daisyaudio/Seed3-DevKit-Eurorack/pcb/Seed3-DevKit-Eurorack-Rev3/Seed3-DevKit-Eurorack-Rev3.kicad_pcb

## KiCad design pcb/Seed3-DevKit-Eurorack-Rev3/Seed3-DevKit-Eurorack-Rev3.kicad_pcb (2026-06-25)

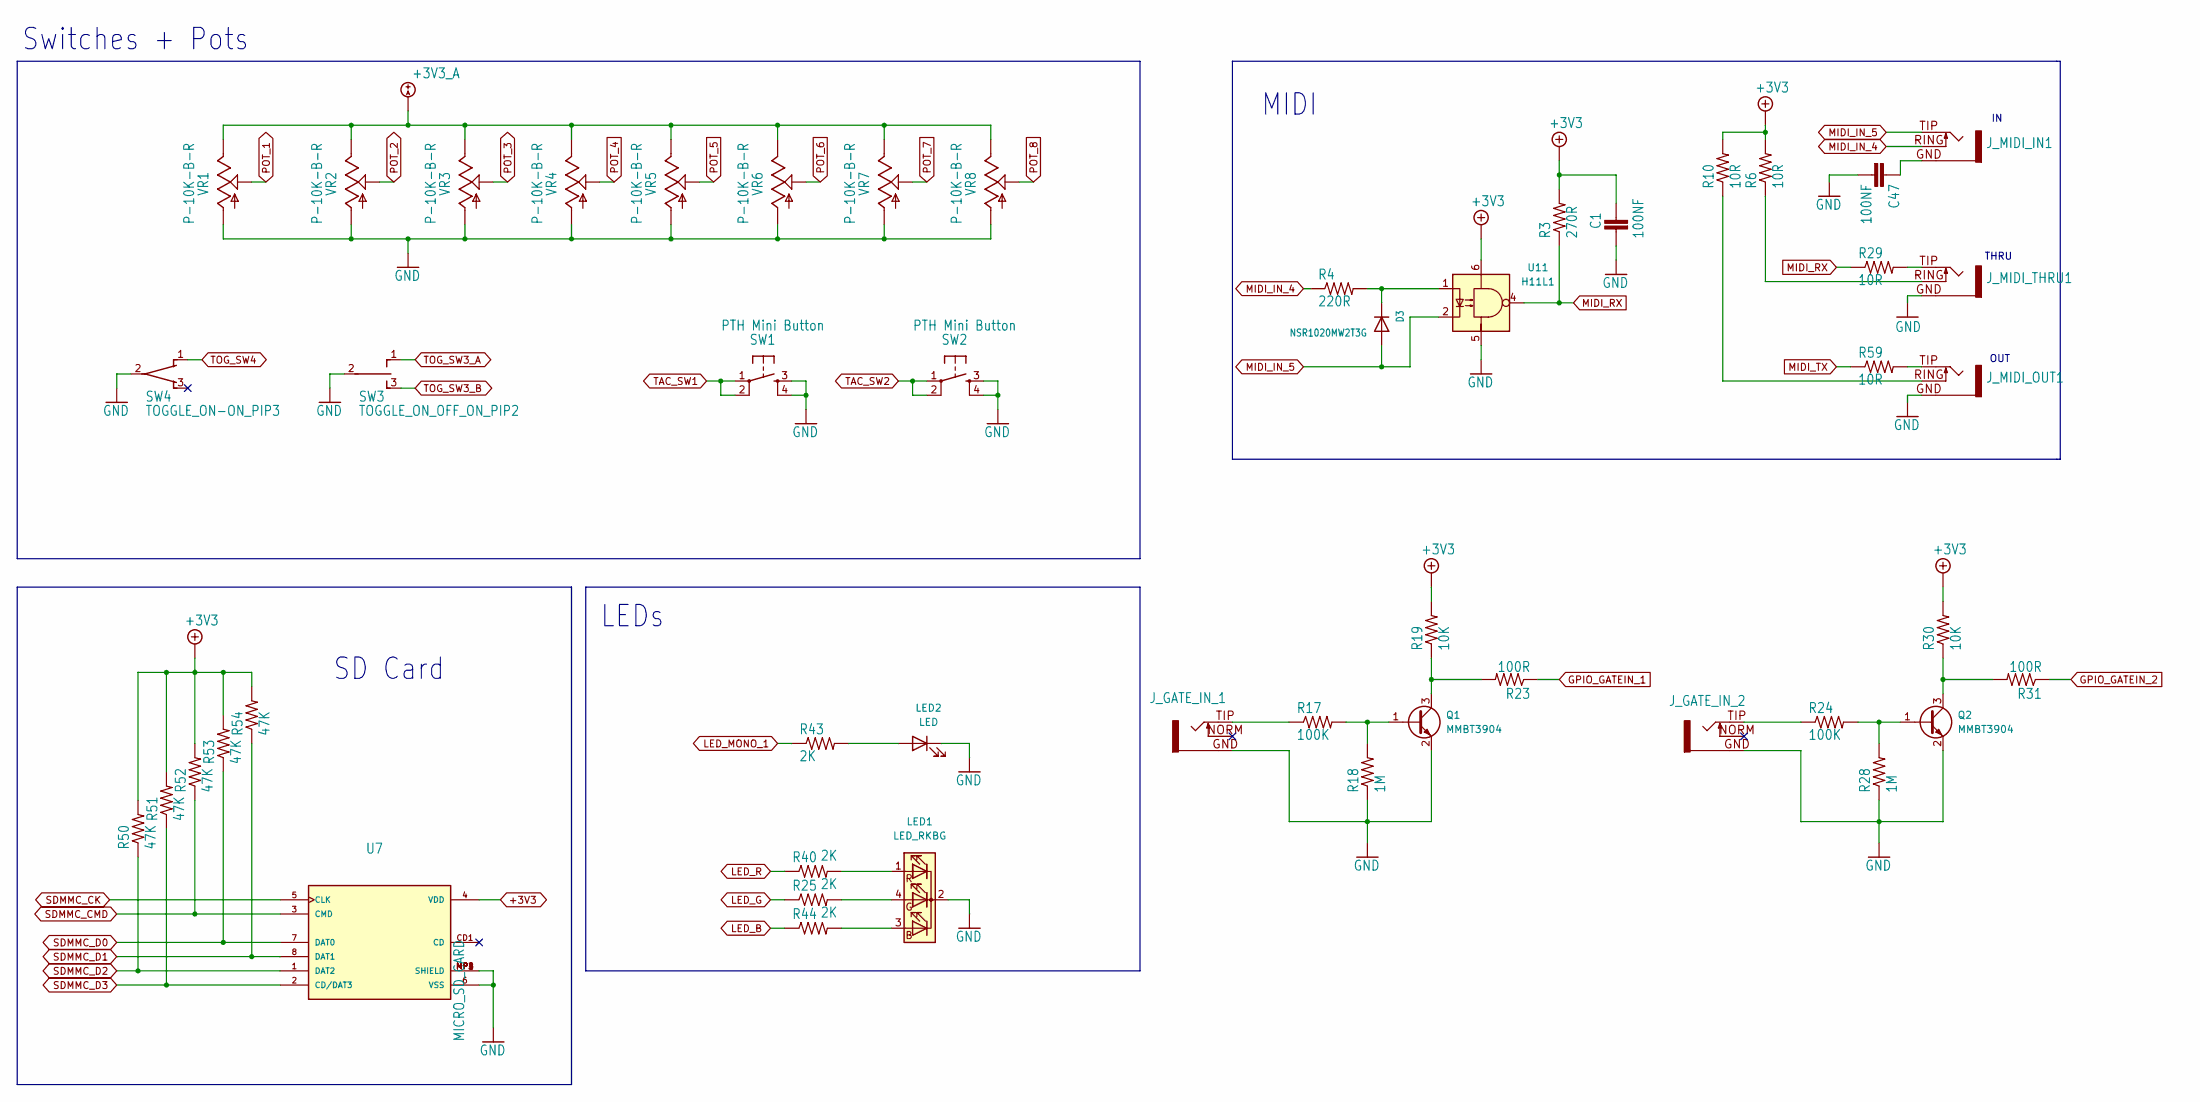
[picture p1: schematic Seed3-DevKit-Eurorack_2.kicad_sch]

Parts:
C1, C47: 100NF; C_0603_1608Metric
D3: NSR1020MW2T3G; D_SOD-323
J_GATE_IN_1, J_GATE_IN_2: S_JACK
J_MIDI_IN1: STEREO_JACK_3.5MM
J_MIDI_OUT1: STEREO_JACK_3.5MM
J_MIDI_THRU1: STEREO_JACK_3.5MM
LED1: LED_RKBG; LED_D5.0mm-4_RGB_Wide_Pins
LED2: LED; LED_D5.0mm
Q1, Q2: MMBT3904; SOT-23
R3: 270R; R_0603_1608Metric
R4: 220R; R_0603_1608Metric
R6, R10, R29, R59: 10R; R_0603_1608Metric
R17, R24: 100K; R_0603_1608Metric
R18, R28: 1M; R_0603_1608Metric
R19, R30: 10K; R_0603_1608Metric
R23, R31: 100R; R_0603_1608Metric
R25, R40, R43, R44: 2K; R_0603_1608Metric
R50, R51, R52, R53, R54: 47K; R_0603_1608Metric
SW1, SW2: PTH Mini Button; TL1105SPF250Q_SILK
SW3: TOGGLE_ON_OFF_ON_PIP2; TOGGLE_ON_OFF_ON_SILK
SW4: TOGGLE_ON-ON_PIP3; TOGGLE_ON-ON_SILK
U7: MICRO_SD_CARD; TF-01A
U11: H11L1; DIP-6_W7.62mm
VR1, VR2, VR3, VR4, VR5, VR6, VR7, VR8: P-10K-B-R; 9MM_SNAP-IN_POT_SILK

Connections:
+3V3: C1.2, R3.2, R6.2, R10.2, R19.2, R30.2, R50.2, R51.2, R52.2, R53.2, R54.2, U7.4 (VDD), U11.6; also elsewhere on the board
+3V3_A: VR1.3, VR2.3, VR3.3, VR4.3, VR5.3, VR6.3, VR7.3, VR8.3; also elsewhere on the board
GND: C1.1, C47.2, J_GATE_IN_1.GND, J_GATE_IN_2.GND, J_MIDI_OUT1.GND, J_MIDI_THRU1.GND, LED1.2 (K), LED2.1 (K), Q1.2 (E), Q2.2 (E), R18.1, R28.1, SW1.3, SW1.4, SW2.3, SW2.4, SW3.2, SW4.2, U7.6 (VSS), U7.MP1 (SHIELD), U7.MP2 (SHIELD), U7.MP3 (SHIELD), U7.MP4 (SHIELD), U11.5, VR1.1, VR2.1, VR3.1, VR4.1, VR5.1, VR6.1, VR7.1, VR8.1; also elsewhere on the board
GPIO_GATEIN_1: R23.1; also elsewhere on the board
GPIO_GATEIN_2: R31.1; also elsewhere on the board
LED_B: R44.1; also elsewhere on the board
LED_G: R25.1; also elsewhere on the board
LED_MONO_1: R43.1; also elsewhere on the board
LED_R: R40.1; also elsewhere on the board
MIDI_IN_4: J_MIDI_IN1.RING (NORM), R4.1
MIDI_IN_5: D3.2 (A), J_MIDI_IN1.TIP, U11.2
MIDI_RX: R3.1, R29.1, U11.4; also elsewhere on the board
MIDI_TX: R59.1; also elsewhere on the board
unnamed: C47.1, J_MIDI_IN1.GND
unnamed: D3.1 (K), R4.2, U11.1
unnamed: J_GATE_IN_1.TIP, R17.1
unnamed: J_GATE_IN_2.TIP, R24.1
unnamed: J_MIDI_OUT1.RING (NORM), R10.1
unnamed: J_MIDI_OUT1.TIP, R59.2
unnamed: J_MIDI_THRU1.RING (NORM), R6.1
unnamed: J_MIDI_THRU1.TIP, R29.2
unnamed: LED1.3 (BA), R44.2
unnamed: LED1.4 (GA), R25.2
unnamed: LED1.1 (RA), R40.2
unnamed: LED2.2 (A), R43.2
unnamed: Q1.1 (B), R17.2, R18.2
unnamed: Q1.3 (C), R19.1, R23.2
unnamed: Q2.1 (B), R24.2, R28.2
unnamed: Q2.3 (C), R30.1, R31.2
POT_1: VR1.2; also elsewhere on the board
POT_2: VR2.2; also elsewhere on the board
POT_3: VR3.2; also elsewhere on the board
POT_4: VR4.2; also elsewhere on the board
POT_5: VR5.2; also elsewhere on the board
POT_6: VR6.2; also elsewhere on the board
POT_7: VR7.2; also elsewhere on the board
POT_8: VR8.2; also elsewhere on the board
SDMMC_CK: U7.5 (CLK); also elsewhere on the board
SDMMC_CMD: R52.1, U7.3 (CMD); also elsewhere on the board
SDMMC_D0: R53.1, U7.7 (DAT0); also elsewhere on the board
SDMMC_D1: R54.1, U7.8 (DAT1); also elsewhere on the board
SDMMC_D2: R50.1, U7.1 (DAT2); also elsewhere on the board
SDMMC_D3: R51.1, U7.2 (CD/DAT3); also elsewhere on the board
TAC_SW1: SW1.1, SW1.2; also elsewhere on the board
TAC_SW2: SW2.1, SW2.2; also elsewhere on the board
TOG_SW3_A: SW3.1 (O); also elsewhere on the board
TOG_SW3_B: SW3.3 (S); also elsewhere on the board
TOG_SW4: SW4.1 (O); also elsewhere on the board

Notes on the sheet:
THRU
MIDI
OUT
Switches + Pots
LEDs
SD Card

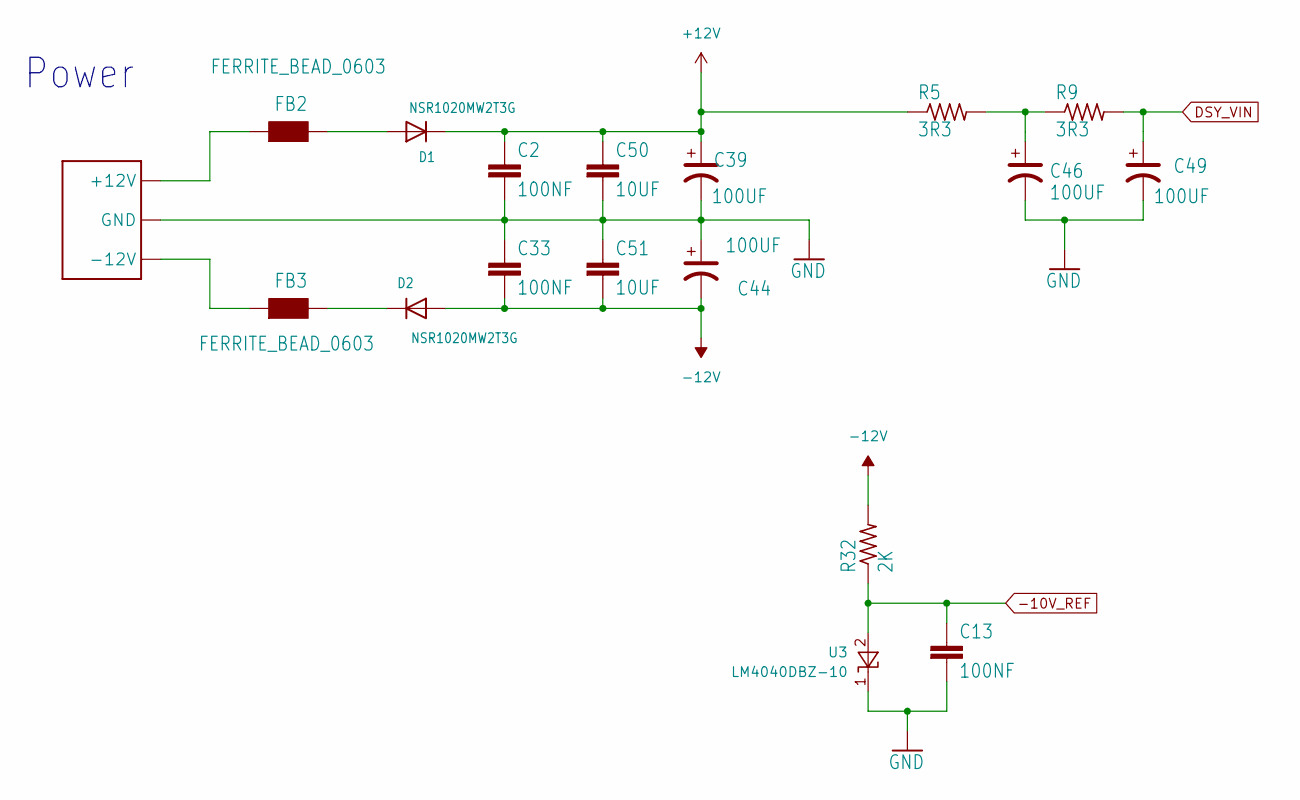
[picture p2: schematic Seed3-DevKit-Eurorack_4.kicad_sch]

Parts:
C2, C13, C33: 100NF; C_0603_1608Metric
C39, C44, C46, C49: 100UF; CP_Elec_6.3x7.7
C50, C51: 10UF; C_0805_2012Metric
D1, D2: NSR1020MW2T3G; D_SOD-323
FB2, FB3: FERRITE_BEAD_0603; R_0603_1608Metric
P1: EURO_PWR_HEADER_LOCK
R5, R9: 3R3; R_1206_3216Metric
R32: 2K; R_0603_1608Metric
U3: LM4040DBZ-10; SOT-23

Connections:
+12V: C2.1, C39.1, C50.1, D1.1 (K), R5.1; also elsewhere on the board
-10V_REF: C13.1, R32.1, U3.2 (A); also elsewhere on the board
-12V: C33.2, C44.2, C51.2, D2.2 (A), R32.2; also elsewhere on the board
DSY_VIN: C49.1, R9.2; also elsewhere on the board
GND: C2.2, C13.2, C33.1, C39.2, C44.1, C46.2, C49.2, C50.2, C51.1, P1.GND1 (GND), P1.GND2 (GND), P1.GND3 (GND), P1.GND4 (GND), P1.GND5 (GND), P1.GND6 (GND), U3.1 (K); also elsewhere on the board
unnamed: C46.1, R5.2, R9.1
unnamed: D1.2 (A), FB2.2
unnamed: D2.1 (K), FB3.2
unnamed: FB2.1, P1.POS1 (+12V), P1.POS2 (+12V)
unnamed: FB3.1, P1.NEG1 (-12V), P1.NEG2 (-12V)

Notes on the sheet:
Power

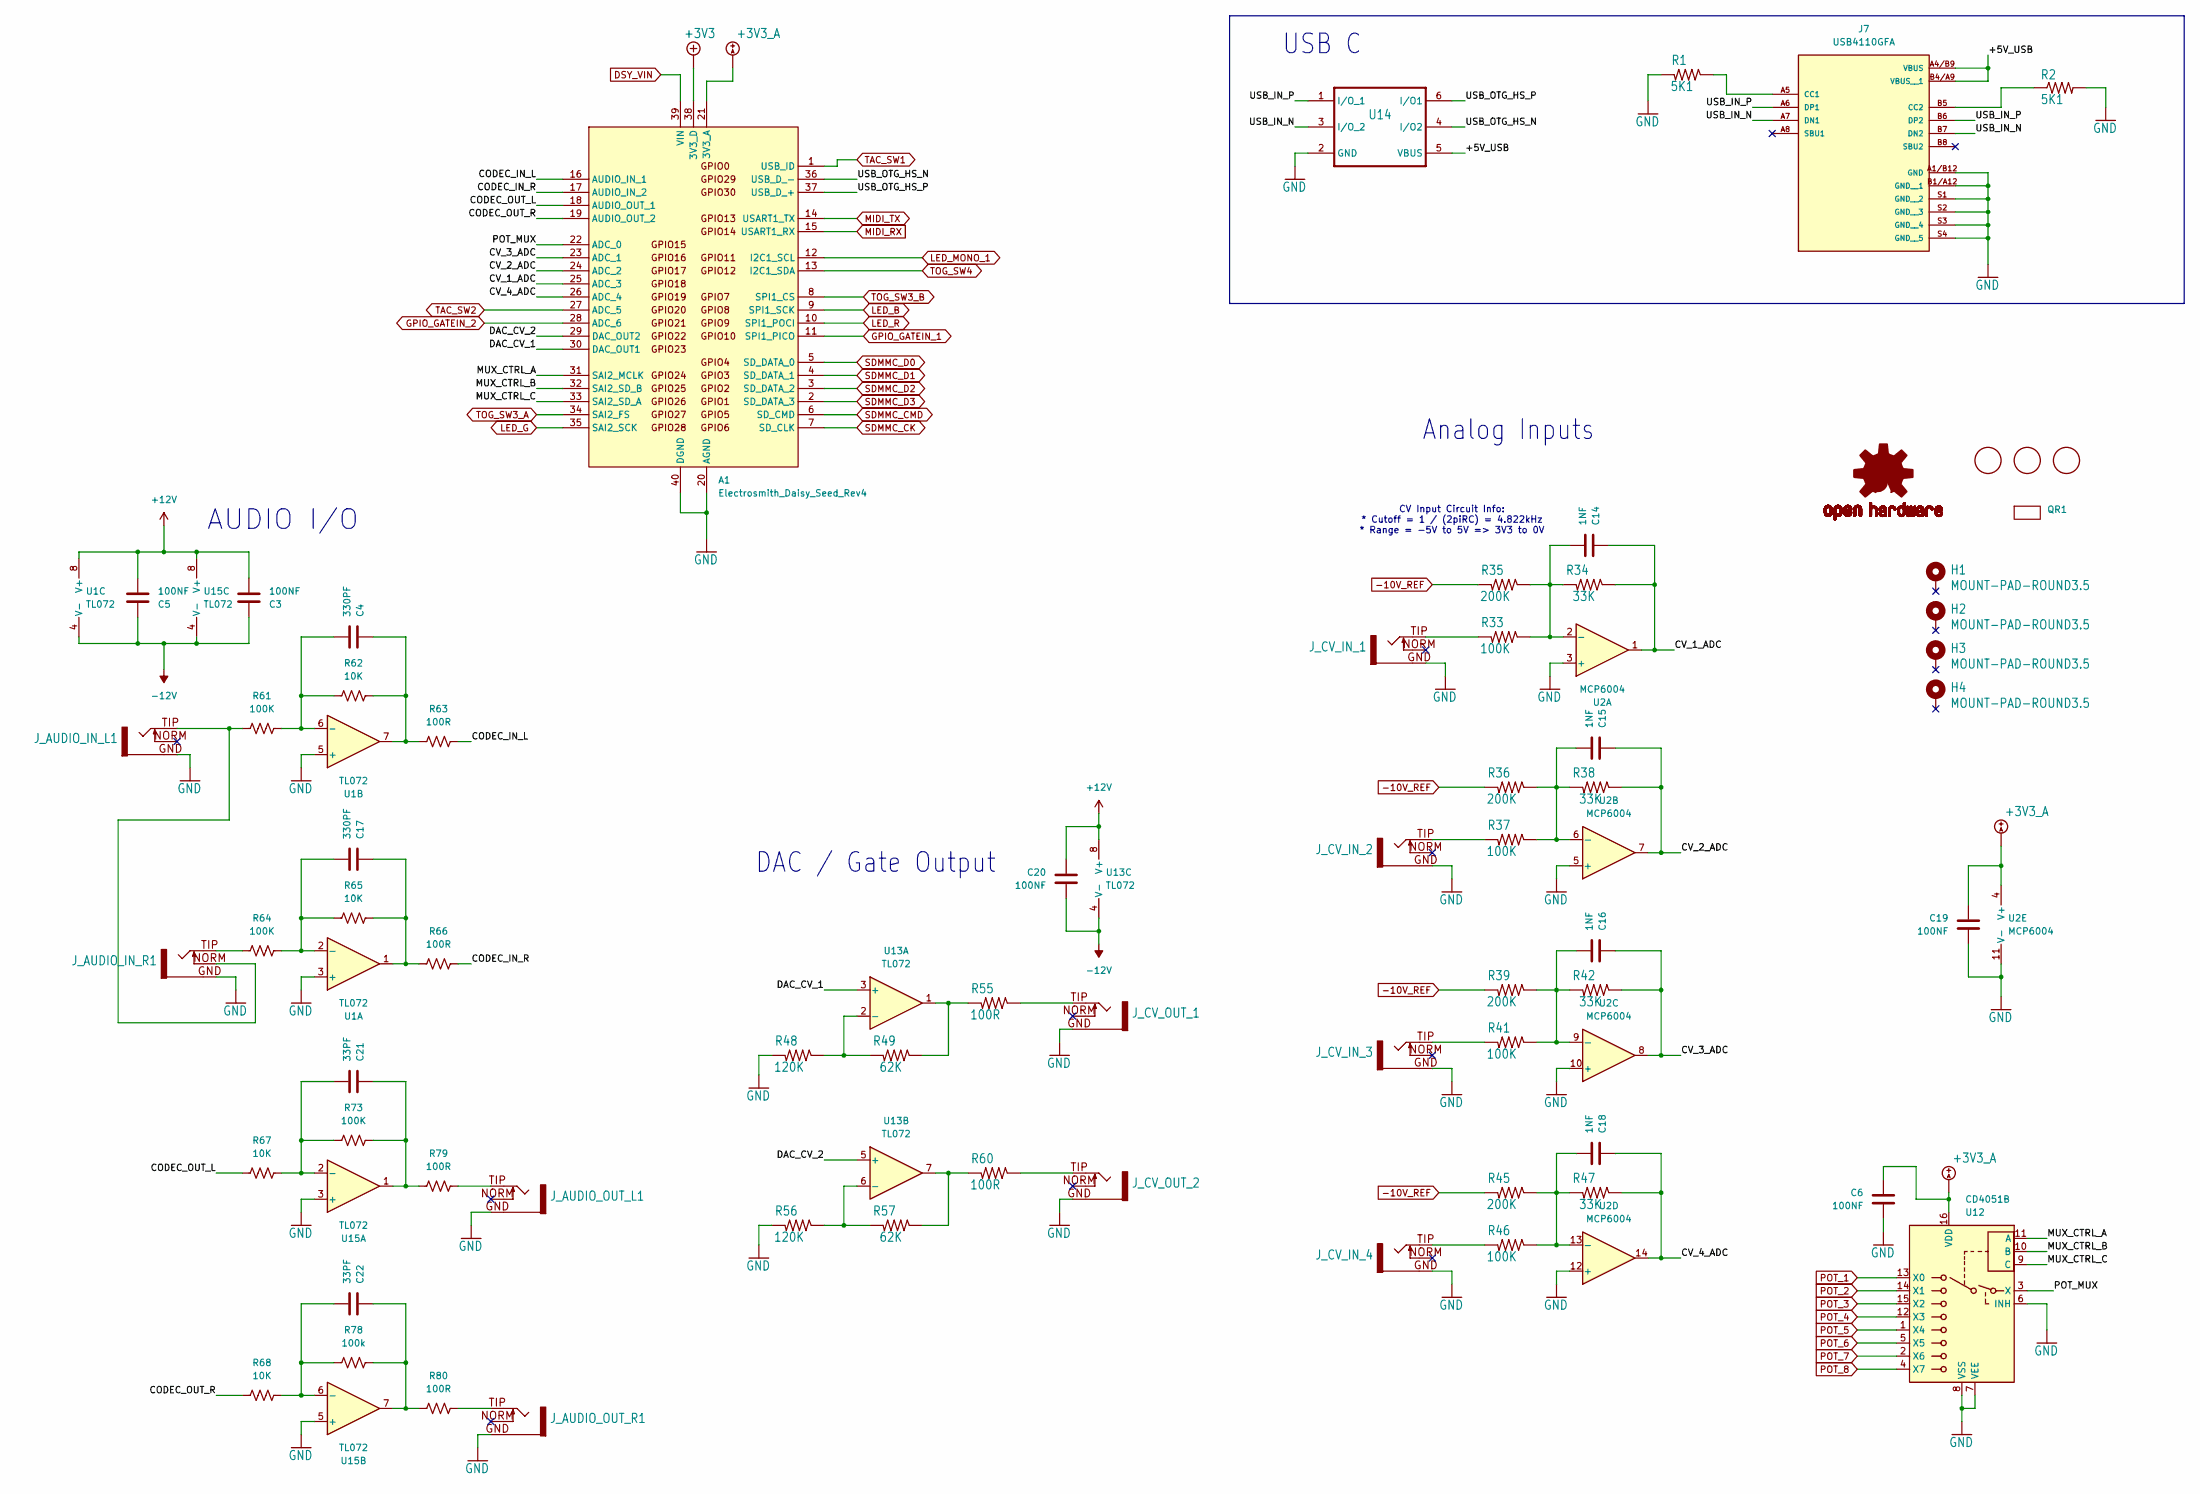
[picture p3: schematic Seed3-DevKit-Eurorack_1.kicad_sch]

Parts:
A1: Electrosmith_Daisy_Seed_Rev4; Electrosmith_Daisy_Seed
C3, C5, C6, C19, C20: 100NF; C_0603_1608Metric
C4, C17: 330PF; C_0603_1608Metric
C14, C15, C16, C18: 1NF; C_0603_1608Metric
C21, C22: 33PF; C_0603_1608Metric
FD1, FD2, FD3: FIDUCIAL; Fiducial_1mm_Mask2mm
H1, H2, H3, H4: MOUNT-PAD-ROUND3.5; MNT_SLOT_M3_PLATED
J7: USB4110GFA; GCT_USB4110GFA
J_AUDIO_IN_L1: S_JACK
J_AUDIO_IN_R1: S_JACK
J_AUDIO_OUT_L1: S_JACK
J_AUDIO_OUT_R1: S_JACK
J_CV_IN_1, J_CV_IN_2, J_CV_IN_3, J_CV_IN_4: S_JACK
J_CV_OUT_1, J_CV_OUT_2: S_JACK
LOGO1: OSHW-LOGO; OSHW-Logo2_14.6x12mm_SilkScreen
QR1: qr-seed3-eurorack-redirect-medium
R1, R2: 5K1; R_0603_1608Metric
R33, R37, R41, R46, R61, R64, R73: 100K; R_0603_1608Metric
R34, R38, R42, R47: 33K; R_0603_1608Metric
R35, R36, R39, R45: 200K; R_0603_1608Metric
R48, R56: 120K; R_0603_1608Metric
R49, R57: 62K; R_0603_1608Metric
R55, R60, R63, R66, R79, R80: 100R; R_0603_1608Metric
R62, R65, R67, R68: 10K; R_0603_1608Metric
R78: 100k; R_0603_1608Metric
U1, U13, U15: TL072; SO-8_3.9x4.9mm_P1.27mm
U2: MCP6004; SO-14_3.9x8.65mm_P1.27mm
U12: CD4051B; SOIC-16_3.9x9.9mm_P1.27mm
U14: USBLC6-2SC6; SOT-23-6

Connections:
+3V3: A1.38 (3V3_D); also elsewhere on the board
+3V3_A: A1.21 (3V3_A), C6.1, C19.1, U2.4 (V+), U12.16 (VDD); also elsewhere on the board
+12V: C3.2, C5.2, C20.1, U1.8 (V+), U13.8 (V+), U15.8 (V+); also elsewhere on the board
-10V_REF: R35.2, R36.2, R39.2, R45.2; also elsewhere on the board
-12V: C3.1, C5.1, C20.2, U1.4 (V-), U13.4 (V-), U15.4 (V-); also elsewhere on the board
/Daisy/+5V_USB: J7.A4/B9 (VBUS), J7.B4/A9 (VBUS__1), U14.5 (VBUS)
/Daisy/CODEC_IN_L: A1.16 (AUDIO_IN_1), R63.1
/Daisy/CODEC_IN_R: A1.17 (AUDIO_IN_2), R66.1
/Daisy/CODEC_OUT_L: A1.18 (AUDIO_OUT_1), R67.2
/Daisy/CODEC_OUT_R: A1.19 (AUDIO_OUT_2), R68.2
/Daisy/CV_1_ADC: A1.25 (ADC_3), C14.1, R34.1, U2.1
/Daisy/CV_2_ADC: A1.24 (ADC_2), C15.1, R38.1, U2.7
/Daisy/CV_3_ADC: A1.23 (ADC_1), C16.1, R42.1, U2.8
/Daisy/CV_4_ADC: A1.26 (ADC_4), C18.1, R47.1, U2.14
/Daisy/DAC_CV_1: A1.30 (DAC_OUT1), U13.3 (+)
/Daisy/DAC_CV_2: A1.29 (DAC_OUT2), U13.5 (+)
/Daisy/MUX_CTRL_A: A1.31 (SAI2_MCLK), U12.11 (A)
/Daisy/MUX_CTRL_B: A1.32 (SAI2_SD_B), U12.10 (B)
/Daisy/MUX_CTRL_C: A1.33 (SAI2_SD_A), U12.9 (C)
/Daisy/POT_MUX: A1.22 (ADC_0), U12.3 (X)
/Daisy/USB_IN_N: J7.A7 (DN1), J7.B7 (DN2), U14.3 (I/O_2)
/Daisy/USB_IN_P: J7.A6 (DP1), J7.B6 (DP2), U14.1 (I/O_1)
/Daisy/USB_OTG_HS_N: A1.36 (USB_D_-), U14.4 (I/O2)
/Daisy/USB_OTG_HS_P: A1.37 (USB_D_+), U14.6 (I/O1)
DSY_VIN: A1.39 (VIN); also elsewhere on the board
GND: A1.20 (AGND), A1.40 (DGND), C6.2, C19.2, J7.A1/B12 (GND), J7.B1/A12 (GND__1), J7.S1 (GND__2), J7.S2 (GND__3), J7.S3 (GND__4), J7.S4 (GND__5), J_AUDIO_IN_L1.GND, J_AUDIO_IN_R1.GND, J_AUDIO_OUT_L1.GND, J_AUDIO_OUT_R1.GND, J_CV_IN_1.GND, J_CV_IN_2.GND, J_CV_IN_3.GND, J_CV_IN_4.GND, J_CV_OUT_1.GND, J_CV_OUT_2.GND, R1.2, R2.2, R48.2, R56.2, U1.3 (+), U1.5 (+), U2.3 (+), U2.5 (+), U2.10 (+), U2.11 (V-), U2.12 (+), U12.6 (INH), U12.7 (VEE), U12.8 (VSS), U14.2 (GND), U15.3 (+), U15.5 (+); also elsewhere on the board
GPIO_GATEIN_1: A1.11 (SPI1_PICO); also elsewhere on the board
GPIO_GATEIN_2: A1.28 (ADC_6); also elsewhere on the board
LED_B: A1.9 (SPI1_SCK); also elsewhere on the board
LED_G: A1.35 (SAI2_SCK); also elsewhere on the board
LED_MONO_1: A1.12 (I2C1_SCL); also elsewhere on the board
LED_R: A1.10 (SPI1_POCI); also elsewhere on the board
MIDI_RX: A1.15 (USART1_RX); also elsewhere on the board
MIDI_TX: A1.14 (USART1_TX); also elsewhere on the board
unnamed: C4.1, R62.1, R63.2, U1.7
unnamed: C17.1, R65.1, R66.2, U1.1
unnamed: C21.1, R73.1, R79.2, U15.1
unnamed: C22.1, R78.1, R80.2, U15.7
unnamed: J7.A5 (CC1), R1.1
unnamed: J7.B5 (CC2), R2.1
unnamed: J_AUDIO_IN_L1.TIP, J_AUDIO_IN_R1.NORM, R61.2
unnamed: J_AUDIO_IN_R1.TIP, R64.2
unnamed: J_AUDIO_OUT_L1.TIP, R79.1
unnamed: J_AUDIO_OUT_R1.TIP, R80.1
unnamed: J_CV_IN_1.TIP, R33.2
unnamed: J_CV_IN_2.TIP, R37.2
unnamed: J_CV_IN_3.TIP, R41.2
unnamed: J_CV_IN_4.TIP, R46.2
unnamed: J_CV_OUT_1.TIP, R55.1
unnamed: J_CV_OUT_2.TIP, R60.1
unnamed: R49.1, R55.2, U13.1
unnamed: R57.1, R60.2, U13.7
unnamed: C17.2, R64.1, R65.2, U1.2 (-)
unnamed: C4.2, R61.1, R62.2, U1.6 (-)
unnamed: C14.2, R33.1, R34.2, R35.1, U2.2 (-)
unnamed: C15.2, R36.1, R37.1, R38.2, U2.6 (-)
unnamed: C16.2, R39.1, R41.1, R42.2, U2.9 (-)
unnamed: C18.2, R45.1, R46.1, R47.2, U2.13 (-)
unnamed: R48.1, R49.2, U13.2 (-)
unnamed: R56.1, R57.2, U13.6 (-)
unnamed: C21.2, R67.1, R73.2, U15.2 (-)
unnamed: C22.2, R68.1, R78.2, U15.6 (-)
POT_1: U12.13 (X0); also elsewhere on the board
POT_2: U12.14 (X1); also elsewhere on the board
POT_3: U12.15 (X2); also elsewhere on the board
POT_4: U12.12 (X3); also elsewhere on the board
POT_5: U12.1 (X4); also elsewhere on the board
POT_6: U12.5 (X5); also elsewhere on the board
POT_7: U12.2 (X6); also elsewhere on the board
POT_8: U12.4 (X7); also elsewhere on the board
SDMMC_CK: A1.7 (SD_CLK); also elsewhere on the board
SDMMC_CMD: A1.6 (SD_CMD); also elsewhere on the board
SDMMC_D0: A1.5 (SD_DATA_0); also elsewhere on the board
SDMMC_D1: A1.4 (SD_DATA_1); also elsewhere on the board
SDMMC_D2: A1.3 (SD_DATA_2); also elsewhere on the board
SDMMC_D3: A1.2 (SD_DATA_3); also elsewhere on the board
TAC_SW1: A1.1 (USB_ID); also elsewhere on the board
TAC_SW2: A1.27 (ADC_5); also elsewhere on the board
TOG_SW3_A: A1.34 (SAI2_FS); also elsewhere on the board
TOG_SW3_B: A1.8 (SPI1_CS); also elsewhere on the board
TOG_SW4: A1.13 (I2C1_SDA); also elsewhere on the board

Notes on the sheet:
USB C
AUDIO I/O
DAC / Gate Output
CV Input Circuit Info: * Cutoff = 1 / (2piRC) = 4.822kHz * Range = -5V to 5V => 3V3 to 0V
Analog Inputs

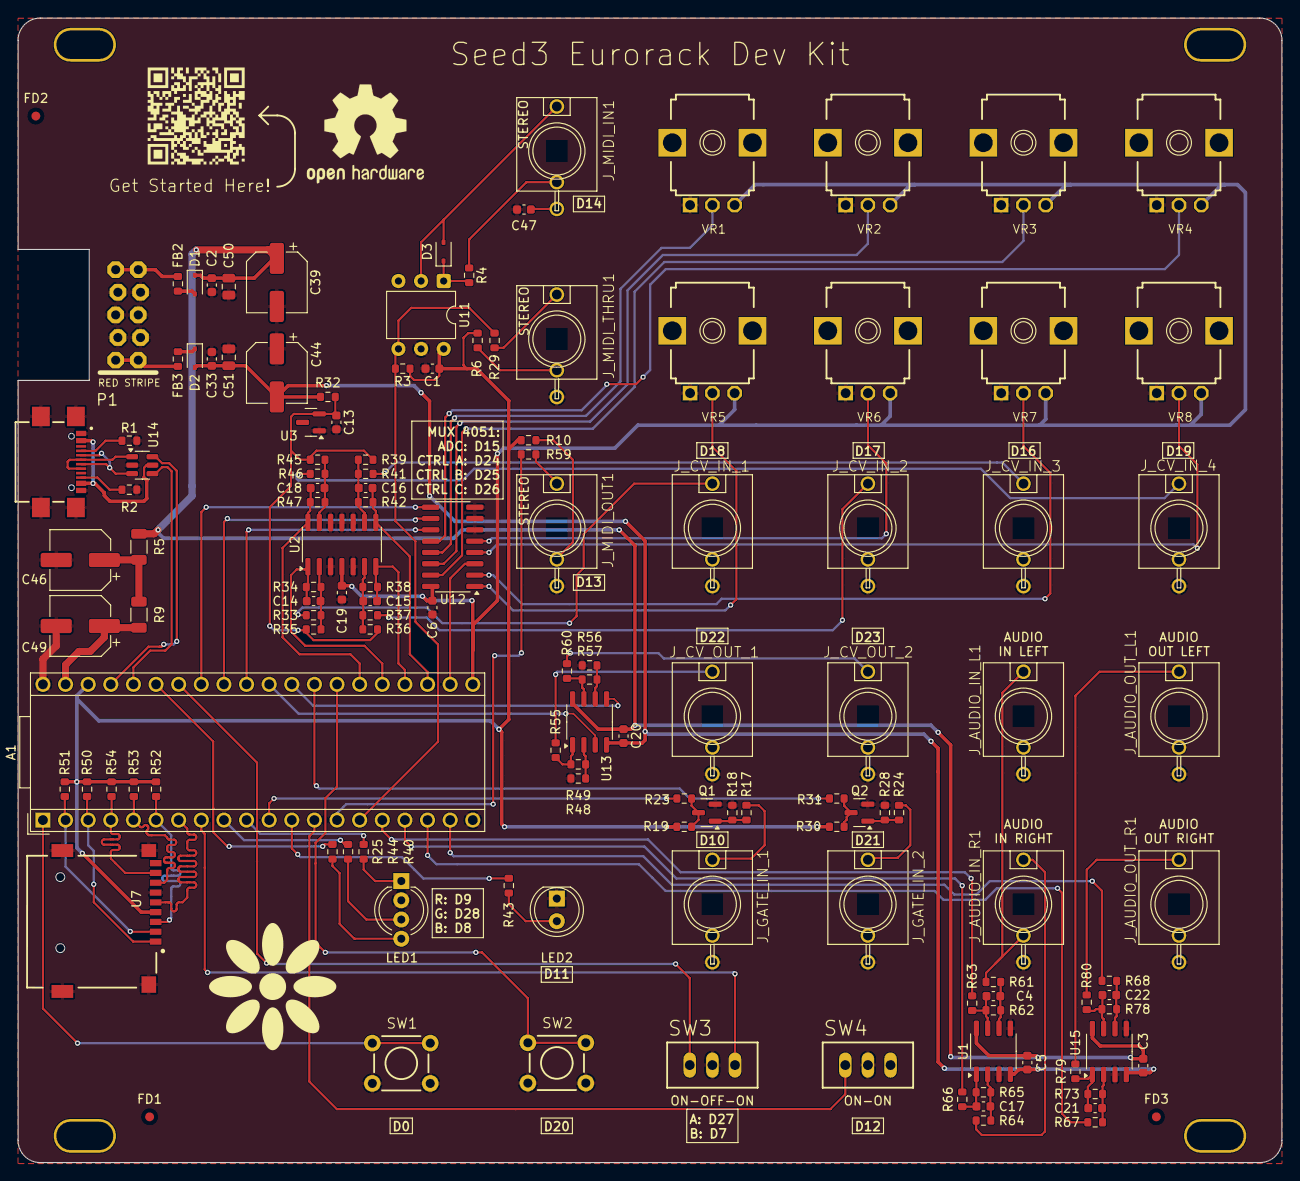
[picture p4: board Seed3-DevKit-Eurorack-Rev3.kicad_pcb from above]

Board: 2 copper layers, 141.9 x 128.5 mm, 139 parts (0 on the bottom side), 104 nets.
